sthancock/TBAG/circuit_diagrams/README.md

# Circuit diagrams

This folder contains circuit diagrams for the circuits used in this Arduino project. The circuit diagrams were drawn in easyEDA, and the files for it are included here.

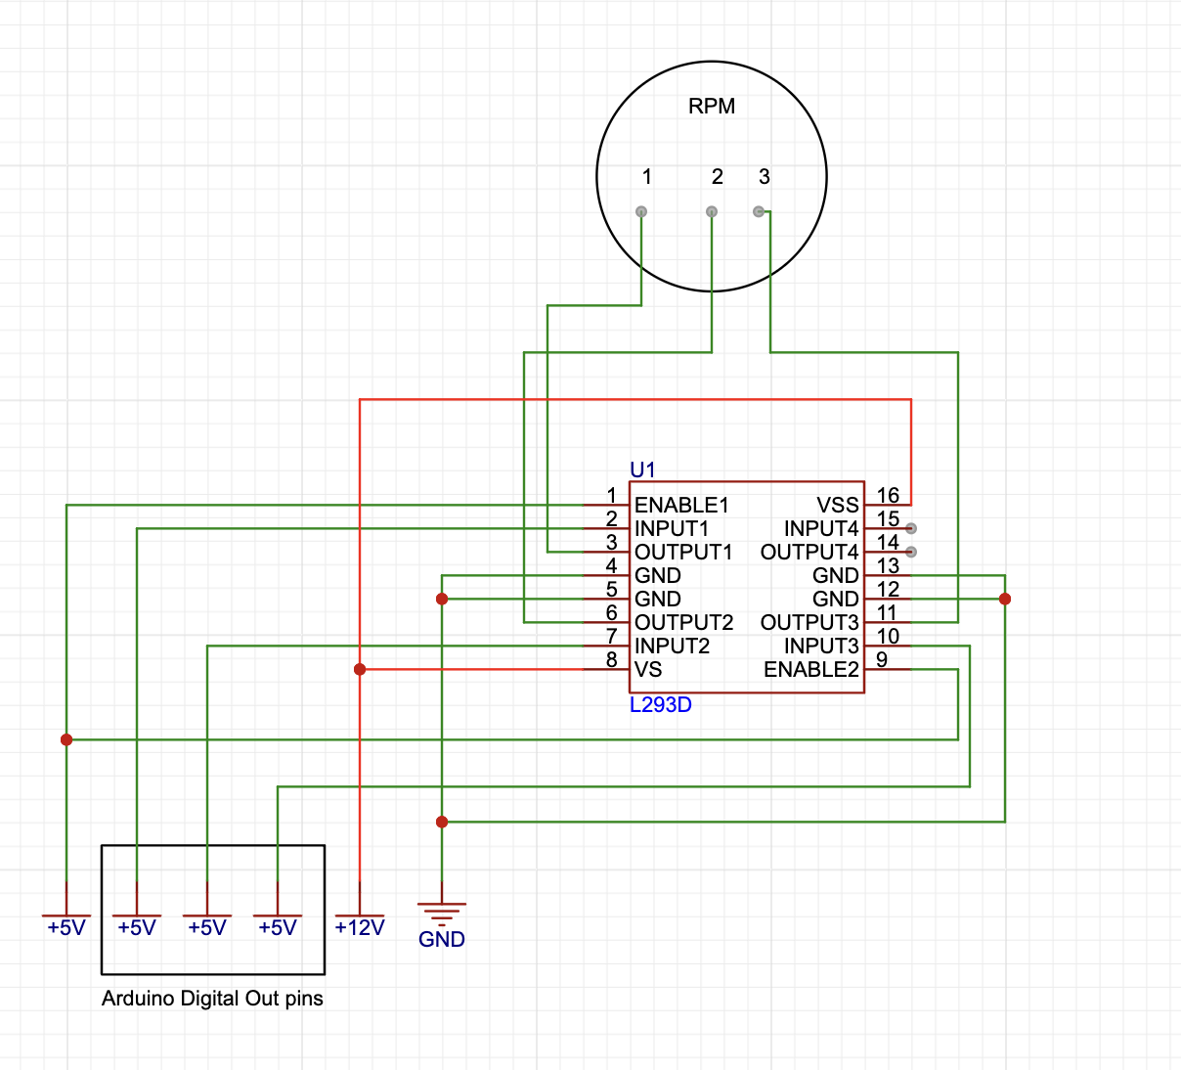
[picture p1: circuit_diagrams/images/RPM_diag.png]
RPM gauge circuit


Note that the dampening reistor in the TGT circuit should be 56 Ohms, as in the whole circuit.

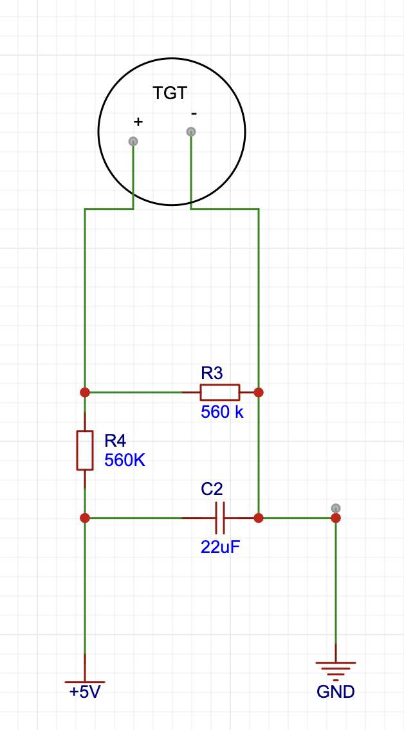
[picture p2: circuit_diagrams/images/TGT_diag.png]
TGT gauge circuit


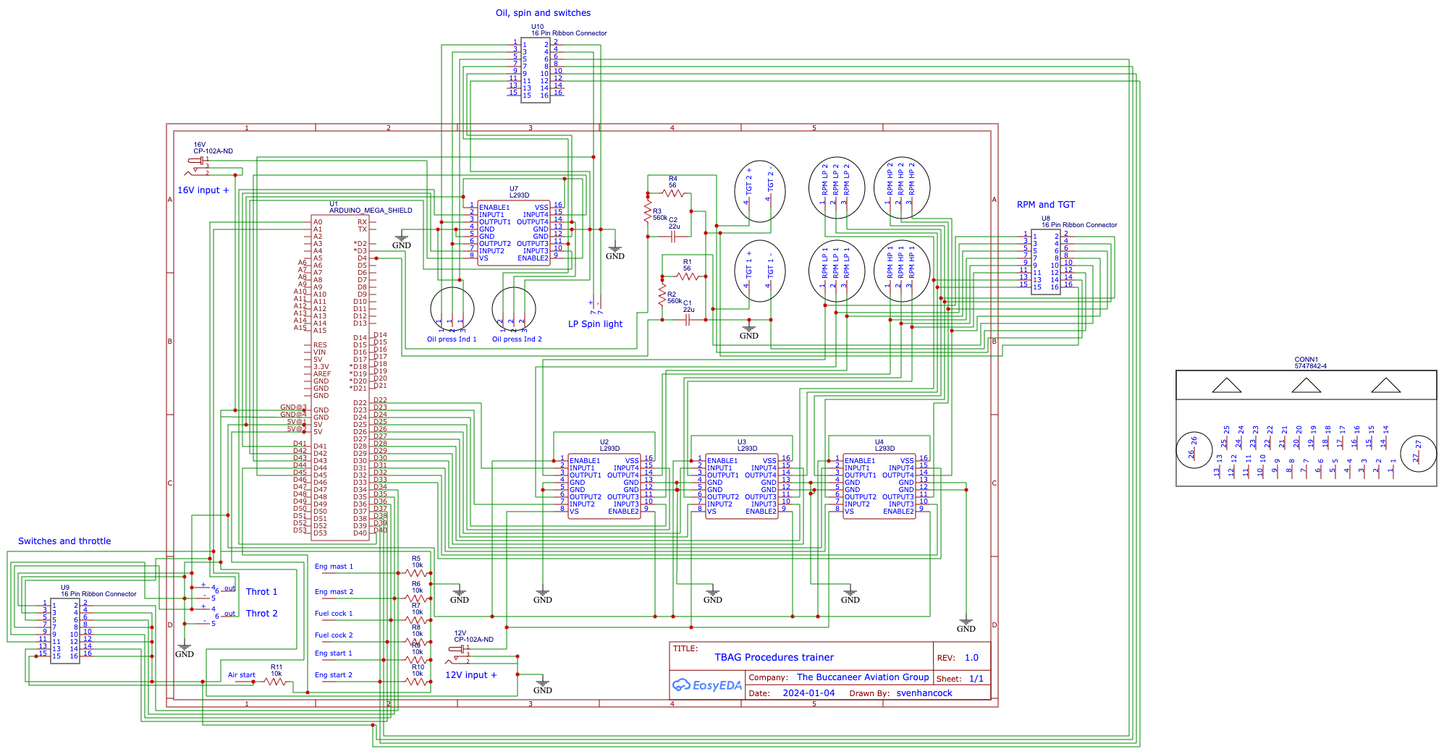
[picture p3: circuit_diagrams/images/TBAG_proc_circuit.png]
Whole circuit
