sthancock/TBAG/learners/eng_physics/README.md

# Engine physics test

This contains a python script to test the engine phsyics before implementing on the Arduino.
