sthancock/TBAG/instrument_test/README.md

# Introduction

This contains code and circuit diagrams to test buccaneer instruments.

## bucc\_procedures

Circuit to test a buccaneer TGT gauge (jet pipe temperature).

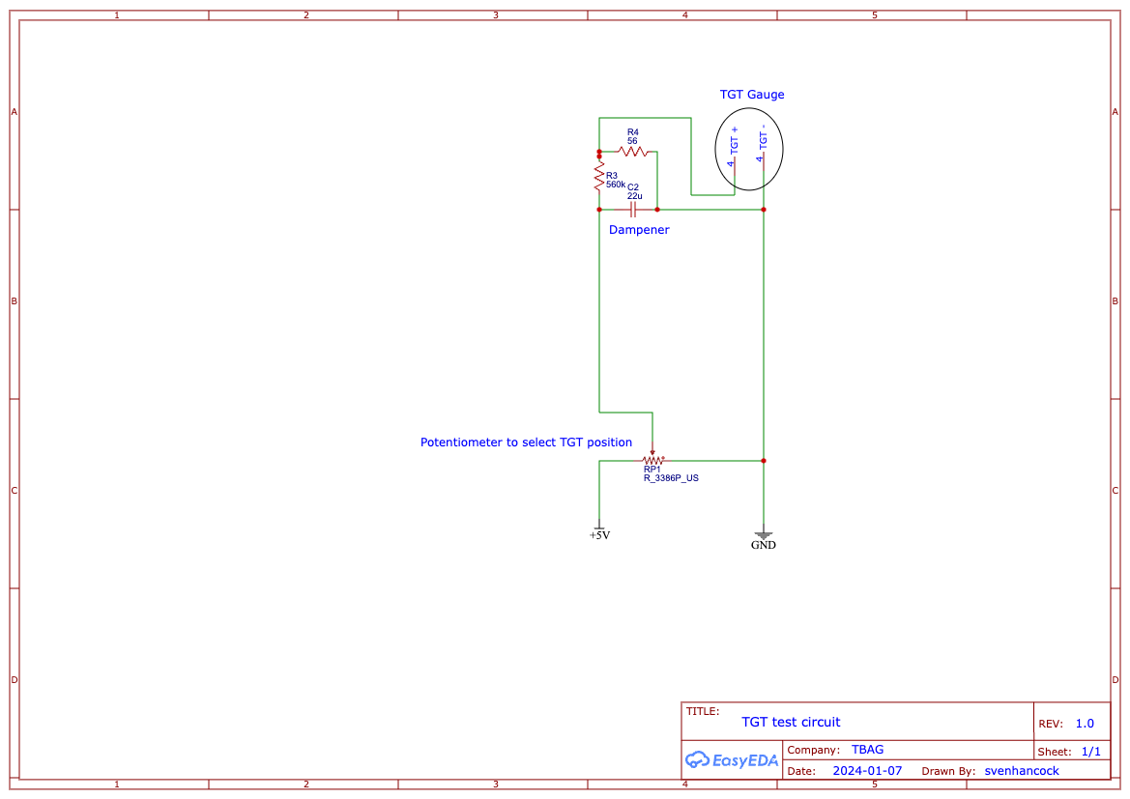
[picture p4: instrument_test/images/TGT_test_circuit.png]
TGT gauge circuit


Note that no code is needed for this circuit, as it only requires a voltage applying.
