sthancock/TBAG/data/instrument_characteristics.xlsx

Instrument | Mode | Resistance | Max voltage | Max Current | Resistor with 5V supply to work
RPM gauge | 3-phase motor | 40 Ohms | ~ 12 V | < 0.6 A | NA
TGT gauge | Varying voltage | 33.5 Ohms | ~ 18 mV | Low | 9.3 k Ohms | 5.6 k Ohms with 56 Ohm dampener
