sthancock/TBAG/circuit_diagrams/easyEDA/Schematic_shield_test_2024-03-02.pdf

16V input + | L293D

## Oil, spin and switches

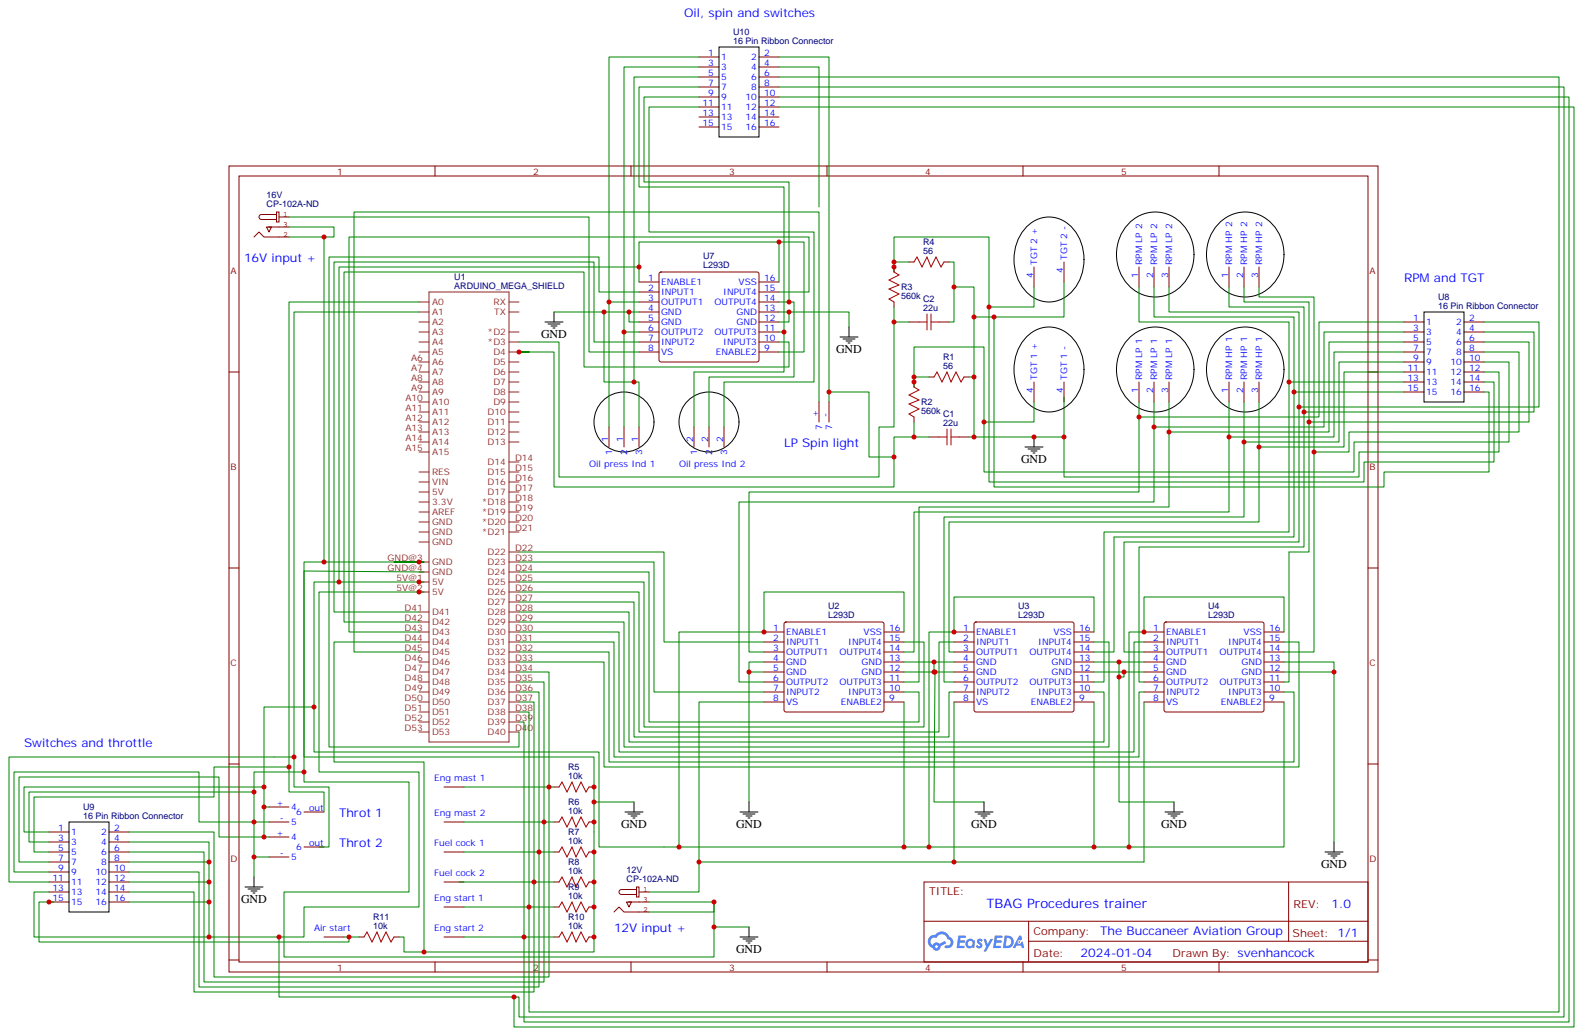
[picture p7: page 1]

Company: The Buccaneer Aviation Group
