sthancock/TBAG/circuit_diagrams/easyEDA/Schematic_shield_test_2024-01-07.pdf

16V input + | L293D

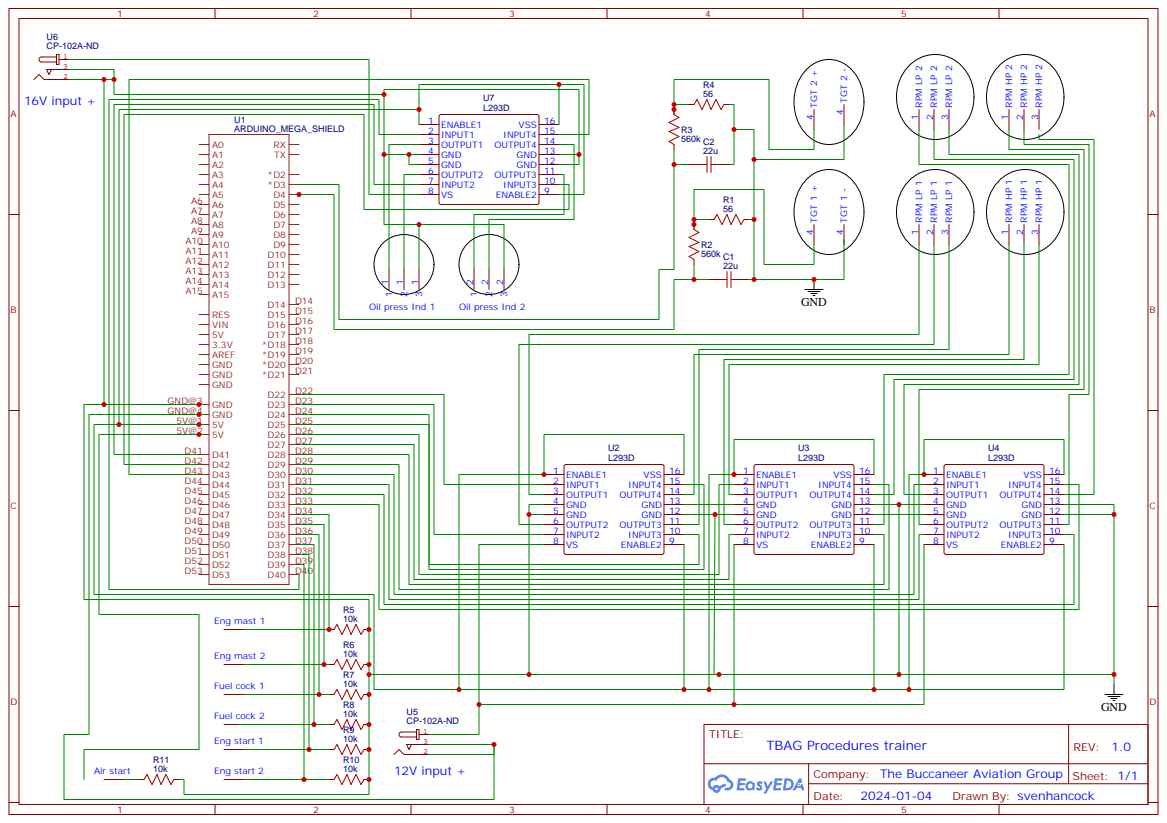
[picture p8: page 1]

Company: The Buccaneer Aviation Group
