sthancock/TBAG/(list of files, drawings)

Other design files:
circuit_diagrams/easyEDA/SCH_shield_test_2024-01-13.json
circuit_diagrams/easyEDA/SCH_shield_test_2024-01-20.json
circuit_diagrams/easyEDA/SCH_shield_test_2024-03-10.json
circuit_diagrams/easyEDA/SCH_shield_test_2024-03-16.json
circuit_diagrams/easyEDA/SCH_test_TGT_2024-01-07.json
circuit_diagrams/easyEDA/TBAG_TGT.eprj
