sthancock/TBAG/(commit log)

2021-05-16 Work on throttle test code.
2021-06-01 Catch added to avoid losing precions during long runs.
    [throttle_test.ino]
2021-07-03 More work on throttle_test2
2021-09-19 throttle_test2 debugged and ready to test on gauge.
2021-12-26 Attempting to get RPM drive working.
    [phase_notes.xlsx]
2021-12-26 Sample code from Scott Boucher added as a starting point.
2021-12-26 Directory reorganised for use in arduino IDE.
2022-01-01 Instrument characteristic table added.
    [instrument_characteristics.xlsx]
2022-01-01 Instrument characteristics updated.
    [instrument_characteristics.xlsx]
2022-01-01 Placeholder for air start switch added.
2022-01-01 Start of PWM writing for JPT gauge.
2022-01-01 JPT gauge now driven, but temperature calculation needs adding.
2022-01-01 A, B and C phases put in correct order.
    [bucc_procedures.ino]
2022-01-02 Circuit diagrams started.
2022-01-02 Work started on circuit diagrams in earnest.
2022-01-02 More work on circuit diagrams.
2022-01-02 Placeholders for more switches added.
2022-01-02 A little more work on engine control switches.
2022-01-02 More work on engine switches.
2022-01-03 Switch pins set to correct values.
    [bucc_procedures.ino]
2022-01-05 Script to calculate TGT resistor added.
    [instrument_characteristics.xlsx]
2022-01-08 Script added to test voltmeter type instruments.
2022-01-09 Engine warning lights added.
    [instrument_characteristics.xlsx]
2022-01-09 Code reorganised to allow separate HP and LP stages.
2022-01-09 Temperature moved to function.
2022-01-09 Oil pressure light only on if master on.
2022-01-09 Throttle down test added.
2022-02-12 Instrument tester not working.
    [bucc_procedures.ino, instrument_test.ino]
2022-02-13 Broken pin on arduino avoided.
    [instrument_test.ino]
2022-02-20 Pin numbers defined as macros for easy changing.
2022-02-21 Debugging of LP stage pins
2024-01-03 Circuit diagramn added.
    [TBAG_TGT.eprj]
2024-01-07 TGT circuit complete.
2024-01-07 Resistance for TGT updated.
    [TBAG_TGT.eprj]
2024-01-07 Resistances updsted.
2024-01-07 Doll's eyes added to circuit diagram.
2024-01-07 Standard EasyEDA files added.
    [SCH_shield_test_2024-01-07.json, SCH_test_TGT_2024-01-07.json]
2024-01-13 Circuit diamgram updated.
2024-01-13 EasyEDA files added.
    [PCB_PCB_shield_test_2024-01-13.json, SCH_shield_test_2024-01-13.json]
2024-01-20 Circuit board files updated.
    [PCB_PCB_shield_test_2024-01-13.json, SCH_shield_test_2024-01-07.json, SCH_shield_test_2024-01-20.json]
2024-03-02 Ground corrected in circuit diagram.
2024-03-07 Pin soldering look up table added.
    [pin_LUT.xlsx]
2024-03-07 Pin LUT updated and bugs noted.
    [pin_LUT.xlsx]
2024-03-08 25 pins allocated.
    [pin_LUT.xlsx]
2024-03-10 Pins updated after soldering.
    [pin_LUT.xlsx]
2024-03-10 Notes added to pin LUT.
    [pin_LUT.xlsx]
2024-03-10 Circuit diagram errors corrected.
    [SCH_shield_test_2024-03-10.json, pin_LUT.xlsx]
2024-03-13 Pin LUT updated.
    [pin_LUT.xlsx]
2024-03-16 PCB debugging.
    [pin_LUT.xlsx]
2024-03-16 Updated easyEDA file.
    [SCH_shield_test_2024-03-16.json]
2024-03-16 Debugging PCB.
